adafruit/Adafruit-FunHouse-PCB/Adafruit FunHouse.sch

## EAGLE design Adafruit FunHouse.sch (2021-04-14)

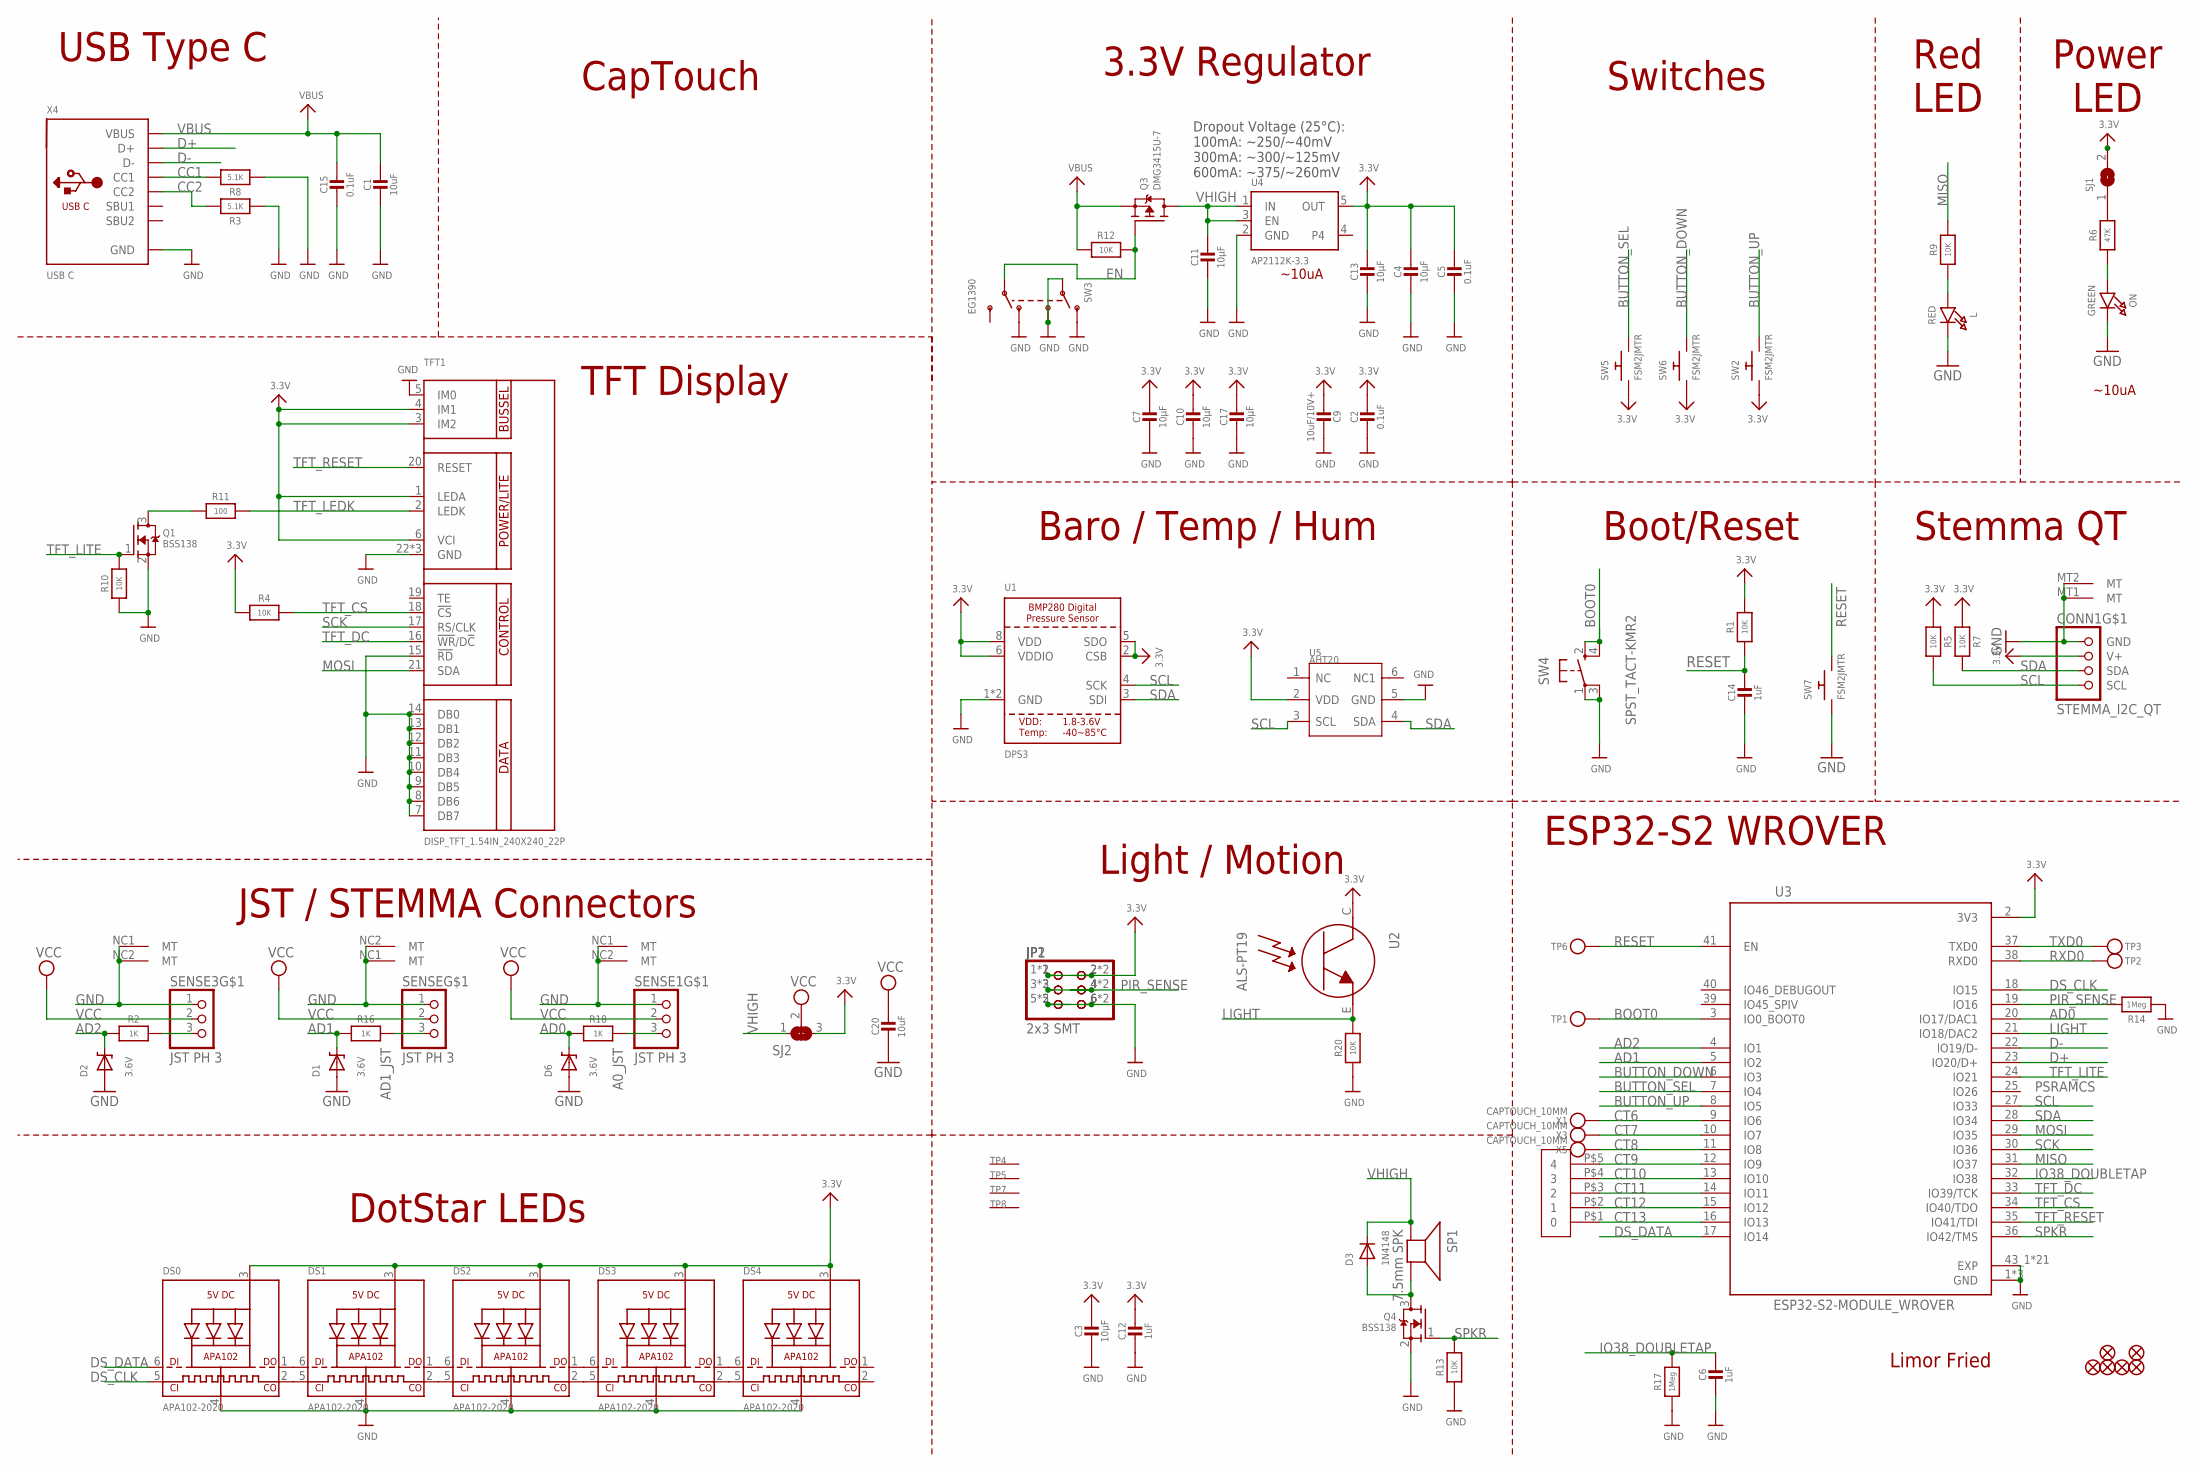
[picture p2: schematic Adafruit FunHouse.sch]

Parts:
C1, C20: 10uF; 0805-NO
C2, C5, C15: 0.1uF; 0603-NO
C3, C4, C7, C10, C11, C13, C17: 10µF; 0805-NO
C6, C12, C14: 1uF; 0603-NO
C9: 10uF/10V+; 0805_10MGAP
CONN1: STEMMA_I2C_QT; JST_SH4
D1, D2, D6: 3.6V; SOD-323
D3: 1N4148; SOD-323F
DS0, DS1, DS2, DS3, DS4: APA102-2020; APA102_2020
FID1, FID2, FID3, FID4, FID5, FID6: FIDUCIAL_1MM
JP1: 2x3 SMT; 2X03_SMT_4UCON_14113
JP2: HEADER-2X3_SMTTHM; 2X03_SMTTHM
L: RED; CHIPLED_0603_NOOUTLINE
ON: GREEN; CHIPLED_0603_NOOUTLINE
Q1: BSS138; SOT23-WIDE
Q3: DMG3415U-7; SOT23-R
Q4: BSS138; SOT23-R
R1, R4, R5, R7, R9, R10, R12, R13, R20: 10K; 0603-NO
R2, R16, R18: 1K; 0603-NO
R3, R8: 5.1K; 0603-NO
R6: 47K; 0603-NO
R11: 100; 0603-NO
R14, R17: 1Meg; 0603-NO
SENSE, SENSE1, SENSE3: JST PH 3; JSTPH3
SJ1: SOLDERJUMPERCLOSED; SOLDERJUMPER_CLOSEDWIRE
SJ2: SOLDERJUMPER_2WAY; SOLDERJUMPER_2WAY_OPEN_NOPASTE
SP1: 7.5mm SPK; BUZZER_SMT_7.5MM
SW2, SW5, SW6, SW7: FSM2JMTR; TACTILE_3X6MM
SW3: EG1390
SW4: SPST_TACT-KMR2; KMR2
TFT1: DISP_TFT_1.54IN_240X240_22P; TFT_1.54IN_240X240_22PIN
TP1, TP2, TP3, TP6: TESTPOINTROUND1.5MMNO; TESTPOINT_ROUND_1.5MM_NO
TP4, TP5, TP7, TP8: SEWTAP_SMTNUTM3; SMT_NUT_3MM
U1: DPS3; BMX280_COMBO
U2: ALS-PT19; ALS-PT19-315C
U3: ESP32-S2-MODULE_WROVER; MODULE_ESP32-S2-WROVER
U4: AP2112K-3.3; SOT23-5
U5: AHT20; SNR6-1.0-3X3X1MM
X1: CAPTOUCH_10MM; CAPTOUCH_6X9MM
X3, X5: CAPTOUCH_10MM; CAPTOUCH_7X9MM
X4: USB C; USB_C_CUSB31-CFM2AX-01-X
X6: CAPTOUCH_5SLIDER_10MM; CAPTOUCH_5SLIDER

Connections:
3.3V: C2.1, C3.1, C4.1, C5.1, C7.1, C9.2, C10.1, C12.1, C13.1, C17.1, CONN1.2 (V+), DS0.3 (VDD), DS1.3 (VDD), DS2.3 (VDD), DS3.3 (VDD), DS4.3 (VDD), JP1.1, JP1.2, JP2.1, JP2.2, R1.2, R4.1, R5.1, R7.1, SJ1.2, SJ2.3, SW2.P$1, SW5.P$1, SW6.P$1, TFT1.1 (LEDA), TFT1.3 (IM2), TFT1.4 (IM1), TFT1.6 (VCI), U1.2 (CSB), U1.5 (SDO), U1.6 (VDDIO), U1.8 (VDD), U2.C, U3.2 (3V3), U4.5 (OUT), U5.2 (VDD)
A0_JST: R18.1, SENSE1.3
A2_JST2: R2.1, SENSE3.3
AD0: D6.C, R18.2, U3.20 (IO17/DAC1)
AD1: D1.C, R16.2, U3.5 (IO2)
AD1_JST: R16.1, SENSE.3
AD2: D2.C, R2.2, U3.4 (IO1)
BOOT0: SW4.2 (S), SW4.4 (S1), TP1.P$1, U3.3 (IO0_BOOT0)
BUTTON_DOWN: SW6.P$2, U3.6 (IO3)
BUTTON_SEL: SW5.P$2, U3.7 (IO4)
BUTTON_UP: SW2.P$2, U3.8 (IO5)
CC1: R8.2, X4.A5 (CC1)
CC2: R3.2, X4.B5 (CC2)
CT6: U3.9 (IO6), X1.P$1
CT7: U3.10 (IO7), X3.P$1
CT8: U3.11 (IO8), X5.P$1
CT9: U3.12 (IO9), X6.P$5 (4)
CT10: U3.13 (IO10), X6.P$4 (3)
CT11: U3.14 (IO11), X6.P$3 (2)
CT12: U3.15 (IO12), X6.P$2 (1)
CT13: U3.16 (IO13), X6.P$1 (0)
D+: U3.23 (IO20/D+), X4.A6 (D+)
D-: U3.22 (IO19/D-), X4.A7 (D-)
DS_CLK: DS0.5 (CKI), U3.18 (IO15)
DS_DATA: DS0.6 (DI), U3.17 (IO14)
EN: Q3.1 (G), R12.2, SW3.P2
GND: C1.2, C2.2, C3.2, C4.2, C5.2, C6.2, C7.2, C9.1, C10.2, C11.2, C12.2, C13.2, C14.2, C15.2, C17.2, C20.2, CONN1.1 (GND), CONN1.MT1 (MT), CONN1.MT2 (MT), D1.A, D2.A, D6.A, DS0.4 (GND), DS1.4 (GND), DS2.4 (GND), DS3.4 (GND), DS4.4 (GND), JP1.5, JP1.6, JP2.5, JP2.6, L.C, ON.C, Q1.2 (S), Q4.2 (S), R3.1, R8.1, R10.1, R13.1, R14.1, R17.1, R20.1, SENSE.1, SENSE.NC1 (MT), SENSE.NC2 (MT), SENSE1.1, SENSE1.NC1 (MT), SENSE1.NC2 (MT), SENSE3.1, SENSE3.NC1 (MT), SENSE3.NC2 (MT), SW3.O1, SW3.O2, SW3.P1, SW3.S1, SW4.1, SW4.3 (P1), SW7.P$1, TFT1.5 (IM0), TFT1.7 (DB7), TFT1.8 (DB6), TFT1.9 (DB5), TFT1.10 (DB4), TFT1.11 (DB3), TFT1.12 (DB2), TFT1.13 (DB1), TFT1.14 (DB0), TFT1.15 (!RD), TFT1.22 (GND), U1.1 (GND), U3.1 (GND), U3.43_1 (EXP), U4.2 (GND), U5.5 (GND), X4.A1B12 (GND)
IO38_DOUBLETAP: C6.1, R17.2, U3.32 (IO38)
LIGHT: R20.2, U2.E, U3.21 (IO18/DAC2)
MISO: R9.2, U3.31 (IO37)
MOSI: TFT1.21 (SDA), U3.29 (IO35)
unnamed: L.A, R9.1
unnamed: R6.2, SJ1.1
unnamed: ON.A, R6.1
unnamed: D3.A, Q4.3 (D), SP1.-
unnamed: DS0.1 (DO), DS1.6 (DI)
unnamed: DS0.2 (CKO), DS1.5 (CKI)
unnamed: DS1.1 (DO), DS2.6 (DI)
unnamed: DS1.2 (CKO), DS2.5 (CKI)
unnamed: DS2.1 (DO), DS3.6 (DI)
unnamed: DS2.2 (CKO), DS3.5 (CKI)
unnamed: DS3.1 (DO), DS4.6 (DI)
unnamed: DS3.2 (CKO), DS4.5 (CKI)
unnamed: Q1.3 (D), R11.1
PIR_SENSE: JP1.3, JP1.4, JP2.3, JP2.4, R14.2, U3.19 (IO16)
RESET: C14.1, R1.1, SW7.P$2, TP6.P$1, U3.41 (EN)
RXD0: TP2.P$1, U3.38 (RXD0)
SCK: TFT1.17 (RS/CLK), U3.30 (IO36)
SCL: CONN1.4 (SCL), R5.2, U1.4 (SCK), U3.27 (IO33), U5.3 (SCL)
SDA: CONN1.3 (SDA), R7.2, U1.3 (SDI), U3.28 (IO34), U5.4 (SDA)
SPKR: Q4.1 (G), R13.2, U3.36 (IO42/TMS)
TFT_CS: R4.2, TFT1.18 (!CS), U3.34 (IO40/TDO)
TFT_DC: TFT1.16 (!WR!/D!C), U3.33 (IO39/TCK)
TFT_LEDK: R11.2, TFT1.2 (LEDK)
TFT_LITE: Q1.1 (G), R10.2, U3.24 (IO21)
TFT_RESET: TFT1.20 (RESET), U3.35 (IO41/TDI)
TXD0: TP3.P$1, U3.37 (TXD0)
VBUS: C1.1, C15.1, Q3.2 (S), R12.1, X4.A4B9 (VBUS)
VCC: C20.1, SENSE.2, SENSE1.2, SENSE3.2, SJ2.2
VHIGH: C11.1, D3.C, Q3.3 (D), SJ2.1, SP1.+, U4.1 (IN), U4.3 (EN)

Notes on the sheet:
Limor Fried
Dropout Voltage (25°C): 100mA: ~250/~40mV 300mA: ~300/~125mV 600mA: ~375/~260mV
PSRAMCS
~10uA
3.3V Regulator
ESP32-S2 WROVER
Switches
Boot/Reset
USB Type C
Red LED
Power LED
DotStar LEDs
JST / STEMMA Connectors
Baro / Temp / Hum
Light / Motion
Stemma QT
TFT Display
CapTouch
